garg-divyansh/CG2111A-Alex/Robot Assembly/code/pyrplidar/README.md

# PyRPlidar   

61845532-a5413e80-aede-11e9-9eee-db8438055619

## Introduction
[PyRPlidar](https://github.com/Hyun-je/pyrplidar) is a python library for Slamtec RPLIDAR series.

* Supports all series (A1, A2 and A3)
* Implement all features of the device
* Simple code & Easy to use
* Use generator pattern (for performance)

ezgif-5-3c5261a0b7fa

## Installation
```sh
$ pip install pyrplidar
```

## Example Code
```Python
from pyrplidar import PyRPlidar

lidar = PyRPlidar()
lidar.connect(port="/dev/ttyUSB0", baudrate=256000, timeout=3)
# Linux   : "/dev/ttyUSB0"
# MacOS   : "/dev/cu.SLAB_USBtoUART"
# Windows : "COM5"

info = lidar.get_info()
print("info :", info)

health = lidar.get_health()
print("health :", health)

samplerate = lidar.get_samplerate()
print("samplerate :", samplerate)

scan_modes = lidar.get_scan_modes()
print("scan modes :")
for scan_mode in scan_modes:
    print(scan_mode)

lidar.disconnect()
```

## Documentation
This library implement full specifications on the [protocol documentation](http://bucket.download.slamtec.com/ccb3c2fc1e66bb00bd4370e208b670217c8b55fa/LR001_SLAMTEC_rplidar_protocol_v2.1_en.pdf) of Slamtec.

## Credits and Acknowledgments
This repository is forked from https://github.com/Hyun-je/pyrplidar.git. All credit to the original author for the Python implementation of SLAMTEC RPLIDAR protocol.
