garg-divyansh/CG2111A-Alex/(commit log)

2026-03-15 Modified sensor array code
2026-03-19 Added Robot Assembly
2026-03-20 Modified Robot Assembly Code
2026-03-22 Added Robot Assembly Handout
2026-04-01 Fixed motors not working
    [sensor_miniproject_template.ino]
2026-04-11 Updated all codebases
    [pi_bot.urdf]
2026-04-11 Updated camera frames
2026-04-29 Refine state diagram for E-stop button behaviour
