garg-divyansh/CG2111A-Alex/(notices)

Notices in the files:
Robot Assembly/code/pyrplidar/README.md:
MIT License
